berkiyo/railway-crossing-simulation/README.md

## railway-crossing-simulation

This project aims to produce a working model of a railway crossing together with a
side street. To view the final product or see how it was built, download the `Berk Dogan - Portfolio` PDF.

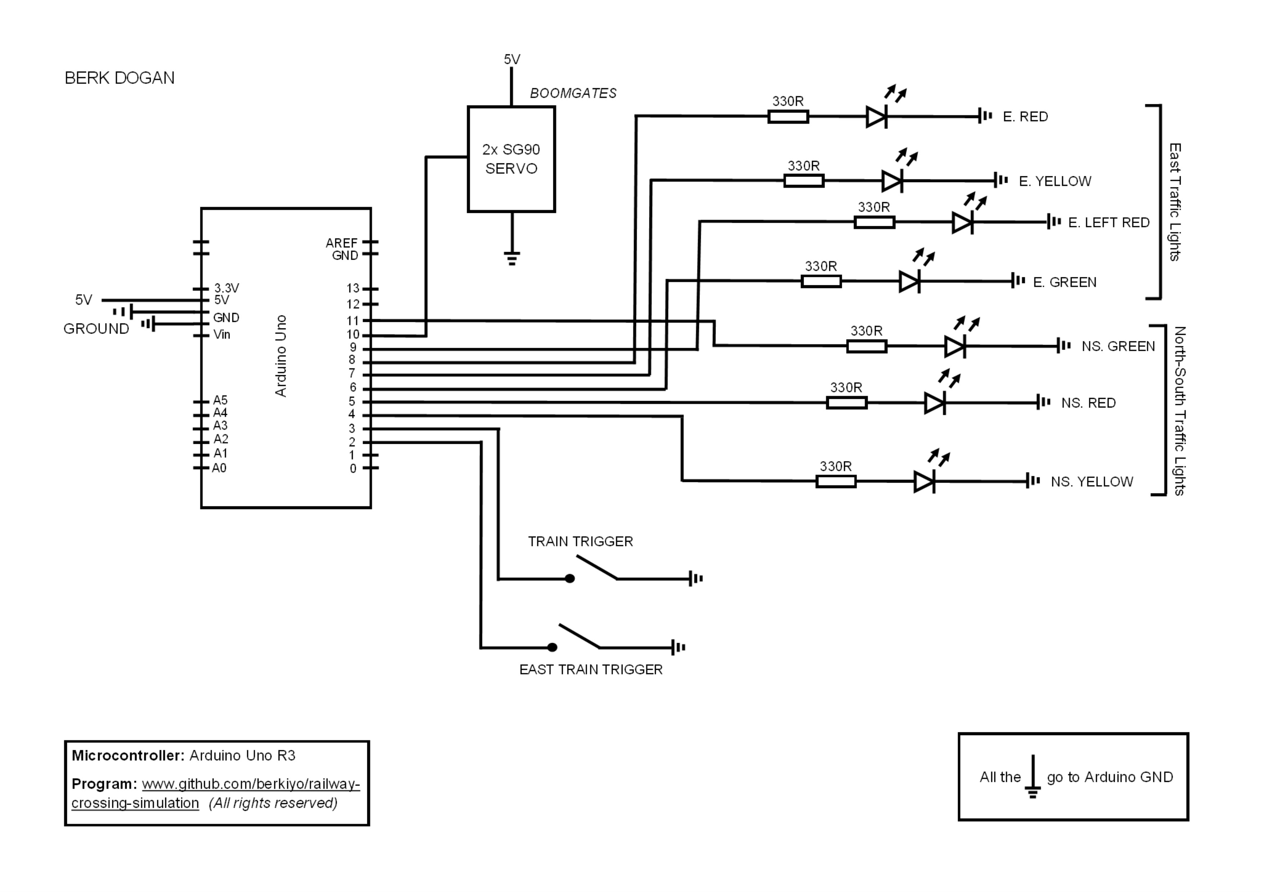
[picture p1: schematic.jpg]
